ams0187/Vupiter/Readme.md

All design sources can be found in ./src/
