ams0187/Vupiter/index.md

# Welcome to Vupiter Control

Vupiter is a modular DC power supply with 3 isolated channels for computer logging and control. A modular power supply control opens the door to boundless experimentation.
Vupiter is intended to support hobbyists where low cost and high flexibility is important.
## [Team](https://ams0187.github.io/Vupiter/members)         
## [Design](https://ams0187.github.io/Vupiter/design) 
## [Team Meetings](https://ams0187.github.io/Vupiter/minutes)
