ams0187/Vupiter/Minutes/11_11_2020.docx

- Group discussion about interface
  - Decided to use one screen per channel instead of one large screen for all three
  - Will use two encoders per channel
- Rice will update the website to be more descriptive of design and match proposal
- Group discussion on control boards
  - Several options for boards, further evaluation of options need to be considered
  - Final board choices to be made later
- Proposal looks good. Team will sign and submit as final proposal.
