ams0187/Vupiter/Pictures/PicComingSoon.JPG

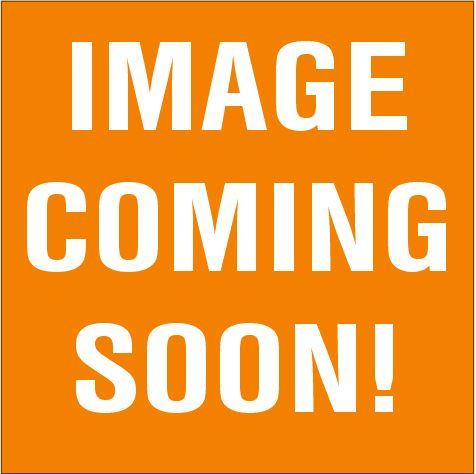
Pictures/PicComingSoon.JPG
