ams0187/Vupiter/ScreenSim/out.png

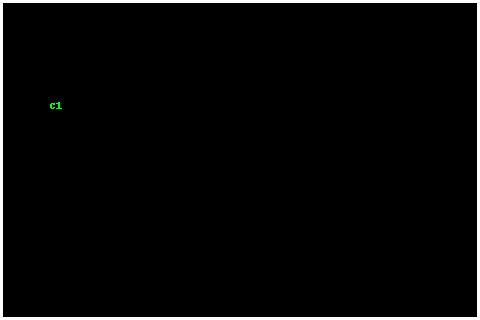
ScreenSim/out.png
