ams0187/Vupiter/Design/Interface_Pugh.xlsx

Sheet: 9 option Pugh
 |  | 7-segment displays |  |  | Screen |  |  | Control
 |  | Option 1 | Option 2 | Option 3 | Option 1 | Option 2 | Option 3 | Option 1 | Option 2 | Option 3
Criteria | Weight | 8 Digit 7-Segment LED Display – MAX7219 | Max7219 8-digit Led Display 7 Segment | 7 Segment Display - 4 Digits | Geekcreit 3.2 Inch MEGA2560 Display Module HX8357B 480x320 TFT LCD Screen | MIKROE-495 MikroElektronika | Geekcreit® IIC I2C 2004 204 | Digital Contacting Encoder | 12mm Incremental Rotary Encoder PEC11 Series 2 Channel | Bourns PEC11R-4225F-S0012 Encoders
Price | 3 | - | - | + | + | - | + | - | + | +
Usability | 2 | 0 | 0 | 0 | + | + | - | 0 | 0 | 0
Quality | 1 | - | - | - | + | + | 0 | + | - | +
Durabilty | 1 | 0 | 0 | 0 | 0 | 0 | 0 | + | 0 | 0
Implementation | 2 | + | + | + | 0 | 0 | 0 | 0 | 0 | 0
+ |  | 0 | 0 | 3 | 6 | 3 | 3 | 2 | 3 | 4
0 |  | 5 | 5 | 5 | 3 | 3 | 4 | 4 | 5 | 5
- |  | 4 | 4 | 1 | 0 | 3 | 2 | 3 | 1 | 0
Total |  | 1 | 1 | 7 | 9 | 3 | 5 | 3 | 7 | 9
 | cost | $5.95 each Nightshade Electronics | $9.95 each adafruit | $ 1.49 each Nightshade Electronics | $8.99 banggood plus $3.00 S&H | $32.24 Digi-key | $7.99 banggood plus $3.00 S&H | $3.00 each Skycraft Parts and Surplus | $1.09 each Jameco Electronics | $1.68 each Newark
 | need | 3 | 6 | 6 | 1 | 1 | 1 | 6 | 6 | 6
 |  |  |  |  |  |  |  | Could use 1 per channel with toggle switch (>$1each) to choose between voltage or current
 |  |  |  |  |  |  |  | 24PPR | 12PPR | 24PPR

Sheet: control Pugh
 |  | Option 1 | Option 2 | Option 3 |  |  | Option 1 | Option 2
Criteria | Weight | Encoders | Buttons | Touchscreen | Criteria | Weight | 7 segment | Touchscreen
Price | 3 | 0 | 0 | 0 | Price | 3 | 0 | 0
Usability | 2 | ++ | - | + | Usability | 2 | 0 | ++
Quality | 1 | 0 | 0 | ++ | Quality | 1 | 0 | 0
Durabilty | 1 | 0 | 0 | 0 | Durabilty | 1 | 0 | 0
Implementation | 2 | 0 | - | 0 | Implementation | 2 | 0 | 0
+ |  | 4 | 0 | 2 | + |  | 0 | 4
0 |  | 7 | 5 | 8 | 0 |  | 9 | 7
- |  | 0 | 4 | 0 | - |  | 0 | 0
Total |  | 11 | 1 | 10 | Total |  | 9 | 11
