ams0187/Vupiter/src/linear/brd/LCSC_Exported_20210309_214545.xlsx

LCSC Part Number | Manufacture Part Number | Manufacturer | Package | Customer # | Description | RoHS | Order Qty. | Min\Mult Order Qty. | Unit Price | Order Price | Product Link
C532871 | SCCD54-6R8MT | Yanchuang | SMD,5.8x5.2x4.5mm |  | 6.8uH ±20% 2A 70mΩ SMD,5.8x5.2x4.5mm Power Inductors RoHS | yes | 10 | 10 | 0.0359 | 0.36 | lcsc.com/product-detail/Power-Inductors_Yanchuang-SCCD54-6R8MT_C532871.html
C532860 | SCCD43-3R3MT | Yanchuang | SMD,4.5x4x3.2mm |  | 3.3uH ±20% 2.25A 85mΩ SMD,4.5x4x3.2mm Power Inductors RoHS | yes | 20 | 20 | 0.0259 | 0.52 | lcsc.com/product-detail/Power-Inductors_Yanchuang-SCCD43-3R3MT_C532860.html
C433658 | RN 1WS 2R2 F T/B A1 | TyoHM | Axial,3.3x9.2mm |  | 2.2Ω ±1% 1W ±100ppm/℃ Axial,3.3x9.2mm Metal Film Resistor (TH) RoHS | yes | 50 | 50 | 0.0173 | 0.87 | lcsc.com/product-detail/Metal-Film-Resistor-TH_TyoHM-RN-1WS-2R2-F-T-B-A1_C433658.html
C307629 | CIGT201610LMR68MNE | Samsung Electro-Mechanics | 0806 |  | 680nH ±20% 2.7A 46mΩ 0806 Power Inductors RoHS | yes | 10 | 10 | 0.0385 | 0.39 | lcsc.com/product-detail/Power-Inductors_Samsung-Electro-Mechanics-CIGT201610LMR68MNE_C307629.html
C400394 | MCS0630-1R5MN2 | PSA(Prosperity Dielectrics) | SMD,7.3x6.6x3mm |  | 1.5uH ±20% 9A 14mΩ SMD,7.3x6.6x3mm Power Inductors RoHS | yes | 10 | 5 | 0.1022 | 1.02 | lcsc.com/product-detail/Power-Inductors_PSA-Prosperity-Dielectrics-MCS0630-1R5MN2_C400394.html
C189432 | PZT3904 | Changjiang Electronics Tech (CJ) | SOT-223 |  | NPN 200mA 40V 1W SOT-223 Transistors (NPN/PNP) RoHS | yes | 10 | 10 | 0.0582 | 0.58 | lcsc.com/product-detail/Transistors-NPN-PNP_Changjiang-Electronics-Tech-CJ-PZT3904_C189432.html
C92603 | TIP41C | STMicroelectronics | TO-220-3 |  | NPN 6A 100V 65W TO-220-3 Transistors (NPN/PNP) RoHS | yes | 10 | 1 | 0.296 | 2.96 | lcsc.com/product-detail/Transistors-NPN-PNP_STMicroelectronics-TIP41C_C92603.html
C176056 | CR2512FR430E04R | Ever Ohms Tech | 2512 |  | 0.43Ω ±1% 1W ±600ppm/°C 2512 Low Resistors & Current Sense Resistors - Surface Mount RoHS | yes | 10 | 10 | 0.0554 | 0.55 | lcsc.com/product-detail/Low-Resistors-Current-Sense-Resistors-Surface-Mount_Ever-Ohms-Tech-CR2512FR430E04R_C176056.html
C382261 | FBF25FP-R300-00L | PSA(Prosperity Dielectrics) | 2512 |  | 0.3Ω ±1% 1W ±100ppm/°C 2512 Low Resistors & Current Sense Resistors - Surface Mount RoHS | yes | 10 | 10 | 0.0516 | 0.52 | lcsc.com/product-detail/Low-Resistors-Current-Sense-Resistors-Surface-Mount_PSA-Prosperity-Dielectrics-FBF25FP-R300-00L_C382261.html
C714300 | CF1/4W-1KΩ±5%T52 | Huaxing Mechanical-Elec. | Axial |  | 1kΩ ±5% 1/4W -1500ppm/℃~+300ppm/℃ Axial Carbon Film Resistors RoHS | yes | 50 | 50 | 0.0056 | 0.28 | lcsc.com/product-detail/Carbon-Film-Resistors_Huaxing-Mechanical-Elec-CF1-4W-1KΩ-5-T52_C714300.html
C111873 | MFR01SF2701A10 | UNI-ROYAL(Uniroyal Elec) | Axial |  | 2.7kΩ ±1% 1W ±50ppm/℃ Axial Metal Film Resistor (TH) RoHS | yes | 50 | 50 | 0.0165 | 0.83 | lcsc.com/product-detail/Metal-Film-Resistor-TH_UNI-ROYAL-Uniroyal-Elec-MFR01SF2701A10_C111873.html
C466811 | SY2512CFR050 | SANYEAR | 2512 |  | 0.05Ω ±1% 3W ±50ppm/°C 2512 Low Resistors & Current Sense Resistors - Surface Mount RoHS | yes | 10 | 10 | 0.0682 | 0.68 | lcsc.com/product-detail/Low-Resistors-Current-Sense-Resistors-Surface-Mount_SANYEAR-SY2512CFR050_C466811.html
C457144 | SY2512CFR100 | SANYEAR | 2512 |  | 0.1Ω ±1% 3W ±50ppm/°C 2512 Low Resistors & Current Sense Resistors - Surface Mount RoHS | yes | 10 | 10 | 0.0722 | 0.72 | lcsc.com/product-detail/Low-Resistors-Current-Sense-Resistors-Surface-Mount_SANYEAR-SY2512CFR100_C457144.html
C385532 | RN1/2WS6.04KΩFT/BA1 | TyoHM | Axial,2.4x6.5mm |  | 6.04kΩ ±1% 1/2W ±50ppm/℃ Axial,2.4x6.5mm Metal Film Resistor (TH) RoHS | yes | 50 | 50 | 0.0129 | 0.65 | lcsc.com/product-detail/Metal-Film-Resistor-TH_TyoHM-RN1-2WS6-04KΩFT-BA1_C385532.html
C520360 | CR6045-4R7N | Ceaiya | SMD,6.0x6.0x4.5mm |  | 4.7uH ±20% 3A 24mΩ SMD,6.0x6.0x4.5mm Power Inductors RoHS | yes | 10 | 10 | 0.0614 | 0.61 | lcsc.com/product-detail/Power-Inductors_Ceaiya-CR6045-4R7N_C520360.html
C207844 | SLO0630H330MTT | Sunltech Tech | SMD,7.1x6.6x3mm |  | 33uH ±20% 2A 270mΩ SMD,7.1x6.6x3mm Power Inductors RoHS | yes | 5 | 5 | 0.1271 | 0.64 | lcsc.com/product-detail/Power-Inductors_Sunltech-Tech-SLO0630H330MTT_C207844.html
C439291 | GCDA0650-470MC | GLE | SMD,7.6x6.6x5mm |  | 47uH ±20% 2.2A 225mΩ SMD,7.6x6.6x5mm Power Inductors RoHS | yes | 10 | 1 | 0.142 | 1.42 | lcsc.com/product-detail/Power-Inductors_GLE-GCDA0650-470MC_C439291.html
C965807 | XL-1608UBC-04 | XINGLIGHT | 0603 |  | 0603 Light Emitting Diodes (LED) RoHS | yes | 100 | 100 | 0.0037 | 0.37 | lcsc.com/product-detail/Light-Emitting-Diodes-LED_XINGLIGHT-XL-1608UBC-04_C965807.html
C513770 | CS2012X5R475K500NRE | Samwha Capacitor | 0805 |  | 4.7uF ±10% 50V X5R 0805 Multilayer Ceramic Capacitors MLCC - SMD/SMT RoHS | yes | 10 | 10 | 0.046 | 0.46 | lcsc.com/product-detail/Multilayer-Ceramic-Capacitors-MLCC-SMD-SMT_Samwha-Capacitor-CS2012X5R475K500NRE_C513770.html
C163508 | CL10C102JB8NNNC | Samsung Electro-Mechanics | 0603 |  | 1nF ±5% 50V C0G 0603 Multilayer Ceramic Capacitors MLCC - SMD/SMT RoHS | yes | 50 | 50 | 0.0069 | 0.35 | lcsc.com/product-detail/Multilayer-Ceramic-Capacitors-MLCC-SMD-SMT_Samsung-Electro-Mechanics-CL10C102JB8NNNC_C163508.html
C376811 | TCC0603X7R151K500CT | CCTC | 0603 |  | 150pF ±10% 50V X7R 0603 Multilayer Ceramic Capacitors MLCC - SMD/SMT RoHS | yes | 100 | 100 | 0.0035 | 0.35 | lcsc.com/product-detail/Multilayer-Ceramic-Capacitors-MLCC-SMD-SMT_CCTC-TCC0603X7R151K500CT_C376811.html
C282519 | TCC0603X7R104K500CT | CCTC | 0603 |  | 100nF ±10% 50V X7R 0603 Multilayer Ceramic Capacitors MLCC - SMD/SMT RoHS | yes | 50 | 50 | 0.0038 | 0.19 | lcsc.com/product-detail/Multilayer-Ceramic-Capacitors-MLCC-SMD-SMT_CCTC-TCC0603X7R104K500CT_C282519.html
C696904 | TCC0603X7R501K500CT | CCTC | 0603 |  | 500pF ±10% 50V X7R 0603 Multilayer Ceramic Capacitors MLCC - SMD/SMT RoHS | yes | 100 | 100 | 0.0033 | 0.33 | lcsc.com/product-detail/Multilayer-Ceramic-Capacitors-MLCC-SMD-SMT_CCTC-TCC0603X7R501K500CT_C696904.html
C466808 | C1206X5R106K500NT | SANYEAR | 1206 |  | 10uF ±10% 50V X5R 1206 Multilayer Ceramic Capacitors MLCC - SMD/SMT RoHS | yes | 30 | 10 | 0.0516 | 1.55 | lcsc.com/product-detail/Multilayer-Ceramic-Capacitors-MLCC-SMD-SMT_SANYEAR-C1206X5R106K500NT_C466808.html
