ams0187/Vupiter/src/linear/brd/2021-03-09T074601.xlsx

Index | Quantity | Part Number | Manufacturer Part Number | Description | Customer Reference | Available | Backorder | Unit Price | Extended Price USD
1 | 3 | ATS2132-ND | ATS-PCBT1090 | HEATSINK TO-220 (DUAL) |  | 3 | 0 | 0.6 | 1.80
2 | 3 | 336-EFM8BB31F16G-D-QFN24RCT-ND | EFM8BB31F16G-D-QFN24R | IC MCU 8BIT 16KB FLASH 24QFN |  | 3 | 0 | 0.91 | 2.73
3 | 6 | 296-TL084HIDRCT-ND | TL084HIDR | QUAD-CHANNEL, COST-OPTIMIZED, HI |  | 6 | 0 | 0.44 | 2.64
