ams0187/Vupiter/src/linear/SCH and PCB/LCSC_Exported_20210309_070508.xlsx

LCSC Part Number | Manufacture Part Number | Manufacturer | Package | Customer # | Description | RoHS | Order Qty. | Min\Mult Order Qty. | Unit Price | Order Price | Product Link
C167641 | VJ0603Y104JXACW1BC | Vishay Intertech | 0603 |  | 100nF ±5% 50V X7R 0603 Multilayer Ceramic Capacitors MLCC - SMD/SMT RoHS | yes | 10 | 5 | 0.081 | 0.81 | lcsc.com/product-detail/Multilayer-Ceramic-Capacitors-MLCC-SMD-SMT_Vishay-Intertech-VJ0603Y104JXACW1BC_C167641.html
C347531 | 10TPU4R7MSI | PANASONIC | 0805 |  | 4.7uF ±20% 10V 300 mΩ @ 100kHz -55℃ ~ +85℃ 0805 Tantalum Capacitors RoHS | yes | 6 | 1 | 0.4996 | 3 | lcsc.com/product-detail/Tantalum-Capacitors_PANASONIC-10TPU4R7MSI_C347531.html
C188728 | HSMG-C170 | AVAGO(Broadcom) | 0805 |  | Green 572nm 0805 Light Emitting Diodes (LED) RoHS | yes | 5 | 5 | 0.1106 | 0.55 | lcsc.com/product-detail/Light-Emitting-Diodes-LED_AVAGO-Broadcom-HSMG-C170_C188728.html
C178425 | ECHU1H151JX5 | PANASONIC | 0805 |  | 150pF ±5% 50V -55℃~125℃ 0805 Mylar Capacitor RoHS | yes | 10 | 1 | 0.2275 | 2.28 | lcsc.com/product-detail/Mylar-Capacitor_PANASONIC-ECHU1H151JX5_C178425.html
C274991 | RFS03JR100A750NH | Futaba Elec | Axial |  | 0.1 ±5% 3W Axial Fusible Chip Resistor RoHS | yes | 20 | 10 | 0.0642 | 1.28 | lcsc.com/product-detail/Fusible-Chip-Resistor_Futaba-Elec-RFS03JR100A750NH_C274991.html
C1713 | CL21A106KOQNNNE | Samsung Electro-Mechanics | 0805 |  | 10uF ±10% 16V X5R 0805 Multilayer Ceramic Capacitors MLCC - SMD/SMT RoHS | yes | 50 | 50 | 0.0159 | 0.8 | lcsc.com/product-detail/Multilayer-Ceramic-Capacitors-MLCC-SMD-SMT_Samsung-Electro-Mechanics-CL21A106KOQNNNE_C1713.html
C237925 | BCIHP0724-4R7M | BC(Bao Cheng Elec) | SMD,7x7x2.4mm |  | 4.7uH ±20% 4.5A 63mΩ SMD,7x7x2.4mm Inductors (SMD) RoHS | yes | 6 | 1 | 0.2739 | 1.64 | lcsc.com/product-detail/Inductors-SMD_BC-Bao-Cheng-Elec-BCIHP0724-4R7M_C237925.html
C84244 | LM317 | Changjiang Electronics Tech (CJ) | SOT-223 |  | Adjustable 40V 1.2V ~ 37V 5V @ 500mA SOT-223 Dropout Regulators(LDO) RoHS | yes | 6 | 1 | 0.2205 | 1.32 | lcsc.com/product-detail/Dropout-Regulators-LDO_Changjiang-Electronics-Tech-CJ-LM317_C84244.html
C426512 | LTR18EZPFLR100 | ROHM Semicon | 0612 |  | 0.1 ±1% 1W 0 ~ +150ppm/°C 0612 High power surface mount resistance RoHS | yes | 10 | 5 | 0.1417 | 1.42 | lcsc.com/product-detail/High-power-surface-mount-resistance_ROHM-Semicon-LTR18EZPFLR100_C426512.html
C380162 | MS0530-1R5M | COILMX | SMD,5.75x5.2x3mm |  | 1.5uH ±20% 6A 20mΩ SMD,5.75x5.2x3mm Inductors (SMD) RoHS | yes | 30 | 1 | 0.1451 | 4.35 | lcsc.com/product-detail/Inductors-SMD_COILMX-MS0530-1R5M_C380162.html
C266431 | SMNR6028-330MT | SXN(Shun Xiang Nuo Elec) | SMD,6x6x3mm |  | 33uH ±20% 1.35A 240mΩ SMD,6x6x3mm Inductors (SMD) RoHS | yes | 10 | 5 | 0.1018 | 1.02 | lcsc.com/product-detail/Inductors-SMD_SXN-Shun-Xiang-Nuo-Elec-SMNR6028-330MT_C266431.html
C118903 | 3362P-1-502 | BOCHEN(Chengdu Guosheng Tech) | 3362P |  | 5K ±10% ±250ppm/℃ 3362P Precision Potentiometer RoHS | yes | 25 | 5 | 0.1464 | 3.66 | lcsc.com/product-detail/Precision-Potentiometer_BOCHEN-Chengdu-Guosheng-Tech-3362P-1-502_C118903.html
