ams0187/Vupiter/src/linear/SCH and PCB/2021-03-02T192338.xlsx

Index | Quantity | Part Number | Manufacturer Part Number | Description | Customer Reference | Available | Backorder | Unit Price | Extended Price USD
1 | 25 | 696-1669-1-ND | CSR2512A0R05F | RES 0.05 OHM 1% 2W 2512 |  | 25 | 0 | 0.414 | 10.35
2 | 10 | 399-14947-1-ND | C0603C112J3GAC7867 | CAP CER 1100PF 25V C0G/NP0 0603 |  | 10 | 0 | 0.288 | 2.88
3 | 50 | 1276-1043-1-ND | CL05A104KA5NNNC | CAP CER 0.1UF 25V X5R 0402 |  | 50 | 0 | 0.0064 | 0.32
4 | 10 | 541-10742-1-ND | RCWL2512R100JNEA | RES 0.1 OHM 5% 1W 2512 |  | 10 | 0 | 0.455 | 4.55
