ams0187/Vupiter/src/switched/pfc/digikey_exported.xlsx

Index | Quantity | Part Number | Manufacturer Part Number | Description | Customer Reference | Available | Backorder | Unit Price | Extended Price USD
1 | 2 | 1779-1381-ND | CPV-PQ20/16-1S-14P-Z | COIL FORMER VERTICAL | pfc coil former | 2 | 0 | 0.87 | 1.74
2 | 3 | 846-BD7692FJ-E2CT-ND | BD7692FJ-E2 | IC PFC CTRLR |  | 3 | 0 | 0.88 | 2.64
3 | 4 | AP3917BS7-13DICT-ND | AP3917BS7-13 | ACDC PSR SWITCHER SO-7 |  | 4 | 0 | 0.58 | 2.32
4 | 4 | 785-AOT190A60CL-ND | AOT190A60CL | MOSFET N-CH 600V 20A TO220 |  | 4 | 0 | 2.17 | 8.68
5 | 2 | 1779-1173-ND | PQ20/16-3C95 | FERRITE CORE 2PC SET |  | 2 | 0 | 1.41 | 2.82
