ams0187/Vupiter/src/switched/iso/2021-03-02T151431.xlsx

Index | Quantity | Part Number | Manufacturer Part Number | Description | Customer Reference | Available | Backorder | Unit Price | Extended Price USD
1 | 10 | 1779-1423-ND | CSV-E25/13/7-1S-6P-C | COIL FORMER VERTICAL |  | 10 | 0 | 0.277 | 2.77
2 | 10 | 1779-1020-ND | E25/13/7-3C94 | FERRITE CORE |  | 10 | 0 | 0.53 | 5.30
