ams0187/Vupiter/(list of files, cad)

Other CAD files:
src/tp4/Keil 8051 v9.60.0 - Debug/src/tp4_main.OBJ
src/tp4/Keil 8051 v9.60.0 - Release/src/tp4_main.OBJ
src/tp4/Keil 8051 v9.60.0 - Release/src/Interrupts.OBJ
src/tp4/Keil 8051 v9.60.0 - Debug/src/InitDevice.OBJ
src/tp4/Keil 8051 v9.60.0 - Release/src/SILABS_STARTUP.OBJ
src/tp4/Keil 8051 v9.60.0 - Debug/src/Interrupts.OBJ
src/tp4/Keil 8051 v9.60.0 - Release/src/InitDevice.OBJ
src/tp4/Keil 8051 v9.60.0 - Debug/src/SILABS_STARTUP.OBJ
