ams0187/Vupiter/src/linear/sim/linear.asc

B1: bv; V=(V(outp)-V(outn))*V(vcont)
C1: cap; 10µ; Rser=0.01
C2: cap; 10µ; Rser=0.01
C3: cap; 150p
C4: cap; 1µ
C5: cap; 20µ; Rser=0.001
C6: cap; 500p
C7: cap; 0.1µ
C8: cap; 1100p
C9: cap; 10µ; Rser=0.2
C10: cap; 10µ; Rser=0.01
C11: cap; 500p
C12: cap; 100p
C13: cap; 100p
C17: cap; 10µ; Rser=1
C18: cap; 10µ; Rser=0.2
D1: schottky; 1N5819
D2: schottky; 1N5819
D3: schottky; 1N5819
D5: schottky; 1N5819
D6: schottky; 1N5819
D7: schottky; 1N5819
D8: schottky; 1N5819
L1: ind2; 28µ; Ipk=2 Rser=0.35
L2: ind; 6.8µ; Rser=28m
L3: ind; 1.5µ; Rser=17m
L4: ind2; 50µ; Ipk=1 Rser=0.745
L5: ind; 1.5µ; Rser=28m
L6: ind; 3.3µ
L7: ind; 5µ; Rser=36.5m
L8: ind; 0.75µ
L9: ind; 0.75µ
L10: ind; 6.8µ; Rser=28m
L11: ind; 3.3µ
Q1: npn; 2N3904
Q2: npn; Qtip41c
Q3: npn; Qtip41c
Q4: npn; 2N3904
R1: res; 0.05
R2: res; 1k
R3: res; 10k
R4: res; 96k
R5: res; 96k
R6: res; 10k
R7: res; 0.44
R8: res; 4k
R9: res; 2.5k
R10: res; 1k
R11: res; 1k
R12: res; 1.76k
R13: res; 0.1
R14: res; 6k
R15: res; 1k
R16: res; 0.1
R17: res; 2
R18: res; 2
R19: res; 60
R20: res; 600
R21: res; 50k
R22: res; 4k
R23: res; 4k
R24: res; 50k
R25: res; 0.3
R26: res; 1.2k
R27: res; 2
R28: res; 3.8k
R29: res; 2
R34: res; 6k
Rfan: res; 50
RL2: res; 1
RL: res; 5
U2: opamp2; TL084
U3: opamp2; TL084
U4: opamp2; TL084
U5: LM317_TRANS
U6: opamp2; TL084
U7: opamp2; TL084
U8: opamp2; TL084
U10: MC33063A-Q1_TRANS
U11: MC33063A-Q1_TRANS
U12: opamp2; TL084
V1: voltage; PULSE(0 0.4 0.5m 1n 1n 10 10)
V2: voltage; 2.4
V4: voltage; PULSE(1 0 0.7m 1u 1u 19 20)
V5: voltage; 7; Rser=0.1666
V6: voltage; SINE(0 1.25 250k); AC 1; Rser=0.16666
V8: voltage; PULSE(0 2.4 0.6m 1n 1n 10 10)
Named nets: 0, isense, iset, vcont, vcc, outp, outn, vset, vgg, v3, v5, fb5, preg, fb3, pg3, AD, vin, vr, vi, vref, iread, vread
.inc TL084.301
.tran 0 0.001 0 startup uic
.meas TRAN I0 PP I(R1) FROM 665u TO 695u
.meas TRAN V0 PP V(outp) FROM 665u TO 695u
.inc TIP41C.LIB
Shared heatsink for the two
.meas TRAN V1 PP V(outp) FROM 0.9m TO 1.0m
from DACs
comes from first stage
.model t0 AKO: Qtip41c (Bf=15)
R15 and R20 should be trimmer pots
This is a dummy load representing the fan
This is a dummy load representing the micro
Dummy load to represent output
Analog control ground plane
Digital ground plane
Power ground plane
Switching ground plane
ignore these
.meas TRAN I1 PP I(R1) FROM 0.9m TO 1.0m
R12 should be 1k+1k pot
low esr
Power rated resistors
Power rated shunt resistor
highish prescion, power rated
highish prescion, power rated
pot resistor dividers
pot resistor dividers
.inc LM317_TRANS.LIB
