ams0187/Vupiter/src/switched/sim/Draft1.asc

C1: cap; 80µ; Rser=0.2
C2: cap; 12.5p
C3: cap; 1n
C4: cap; 100n
C5: cap; 10µ
C6: cap; 220p
C7: cap; 1µ
D1: diode
D2: diode
D3: diode
D4: diode
D5: diode
L1: ind; 6µ
Lmag: ind; 900µ
Lp: ind2; 90µ
Ls: ind2; 22.5µ
M1: nmos
M2: nmos
R1: res; 100
R2: res; 2Meg
R3: res; 5.571k
R4: res; 10k
R5: res; 2
R6: res; 10k
R7: res; 2
R8: res; 2
R9: res; 51
R10: res; 10
R11: res; 10k
Rcomp: res; 17.5k
Rsense: res; 0.444
Rt: res; 17.16k
U1: NCP1252A
U2: UCC27714_TRANS
V1: voltage; 400
V2: voltage; 12
V3: voltage; 20
Named nets: 0, vin, sense, bo_div, hs, ho, h_d, l_d, drv, vcc
K1 Lp Ls 1
.tran 0.5
