ams0187/Vupiter/src/switched/sim/Draft2.asc

M1: nmos
M2: pmos
M3: nmos
M4: nmos
M5: pmos
M6: pmos
Named nets: g, vcc, a, b, c, d
