ams0187/Vupiter/src/switched/sim/Draft4.asc

M1: nmos
M2: pmos
Named nets: a, vcc, g, d
