ams0187/Vupiter/src/switched/sim/Draft5.asc

M2: nmos
M3: nmos
M7: pmos
M8: pmos
M9: nmos
M10: pmos
Named nets: a, b, vcc, g, z
