ams0187/Vupiter/(commit log)

2021-01-27 Linear stage design initial
2021-02-08 Create SCH and PCB
2021-02-15 pfc board rev 1
    [LCSC_Exported_20210215_121240.xlsx, digikey_exported.xlsx, iso.kicad_pcb, iso.sch, pfc.kicad_pcb, pfc.sch]
2021-02-22 fixes to pfc schematic for legibility
    [pfc.kicad_pcb]
2021-02-22 footprint fix for AC input
    [pfc.kicad_pcb, pfc.sch]
2021-02-22 pfc footprint fix
    [LCSC_Exported_20210215_121240.xlsx, digikey_exported.xlsx, pfc.sch]
2021-02-22 fixing footprint references
    [pfc.sch]
2021-02-22 fixing the pfc footprints and relating them to their lcsc counterparts
    [LCSC_Exported_20210215_121240.xlsx, pfc.kicad_pcb, pfc.sch]
2021-03-02 isolation stage rev 1
    [2021-03-02T151431.xlsx, LCSC_Exported_20210215_121240.xlsx, LCSC_Exported_20210303_051402.xlsx, iso.sch]
2021-03-08 Midterm report
    [iso.sch, pfc.sch]
2021-03-09 v2 of linear board
    [2021-03-09T074601.xlsx, LCSC_Exported_20210303_051402.xlsx, LCSC_Exported_20210309_214545.xlsx, brd.kicad_pcb, brd.sch]
2021-03-09 Iso output changed to ceramic caps
    [LCSC_Exported_20210303_051402.xlsx, iso.kicad_pcb, iso.sch]
2021-03-10 Damped filters on linear stage
    [brd.kicad_pcb, brd.sch]
2021-03-10 Updated lcsc cart to reflect new inductors
    [LCSC_Exported_20210309_214545.xlsx]
2021-03-11 Faster gate drive on pfc
    [LCSC_Exported_20210215_121240.xlsx, pfc.kicad_pcb, pfc.sch]
2021-03-11 Low effort input filter added to pfc, vestigial input port remains for potential issues
    [LCSC_Exported_20210215_121240.xlsx, pfc.kicad_pcb, pfc.sch]
2021-04-04 final boards and initial blinky
    [InitDevice.OBJ, SILABS_STARTUP.OBJ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]
2021-04-15 more basic software stuff
    [InitDevice.OBJ, SILABS_STARTUP.OBJ, tp4_main.OBJ]
2021-04-18 efm changes
    [InitDevice.OBJ, Interrupts.OBJ, SILABS_STARTUP.OBJ, tp4_main.OBJ]
2021-04-19 minor pin changes
    [InitDevice.OBJ, Interrupts.OBJ, SILABS_STARTUP.OBJ, tp4_main.OBJ]
2021-04-21 report initial 1
    [InitDevice.OBJ, Interrupts.OBJ, SILABS_STARTUP.OBJ, brd.csv, iso.csv, pfc.csv, tp4_main.OBJ]
2021-04-22 current calibration for midboard
    [Interrupts.OBJ]
2021-04-22 final before demo
    [InitDevice.OBJ, Interrupts.OBJ, SILABS_STARTUP.OBJ, tp4_main.OBJ]
